growbx/growbx-KiCAD-Lib/README.md

# growbx-KiCAD-Lib
Internal KiCAD component library for all growbox electrical systems.

Format and organiztion of this library follows AVR-Method found here:
https://github.com/adamjvr/AVR-method
