growbx/growbx-KiCAD-Lib/(commit log)

2020-02-26 MGM210P Module
    Footprint and schematic symbol created for MGM210P module. Capacitor and Resitor footprints added.
2020-02-26 MCP23017
    MCP23017 symbol and footprint added to library
2020-02-28 Ti 3D
    3D File added to Ti ADC and scaled accordingly
2020-02-28 Caps and Res
    Capacitors and Resistor footprints modified with 3D models. 4K7 and 10K resistores added to library.
2020-02-28 Resistors, Capacitor, and Switch
    Standard selection of resistors for digital systems added to library. Basic bypass capacitors, analog, and digital filtering caps added as well. Development reset switch also added.
2020-02-29 SHT35
    SHT35 sensor added to library with 3D model
2020-02-29 Link
    Symbol and footprint linked for SHT35,
2020-03-01 Molex USB
    USB micro B connector from Molex added, 1050170001
    USB - micro B USB 2.0 Receptacle Connector 5 Position Surface Mount, Right Angle; Through Hole
2020-03-01 Battery Holder
    Battery Holder BK-912 for 2032 coin cell batterys added
2020-03-01 LDO 3.3V regulator
    LDO regulator for 3.3V rail when USB powered. AP7361C-33FGE-7
    Linear Voltage Regulator IC 1 Output 1A U-DFN3030-8 (Type E)
2020-03-01 Ceramic Cap
    Ceramic cap added for voltage regulator GRM155R61A475MEAAD.
    4.7µF ±20% 10V Ceramic Capacitor X5R 0402 (1005 Metric)
2020-03-02 Adjustments and Inductor
    Power inductor and components adjusted for readability
2020-03-02 Diode and Transistor
    Added a diode and transistor for USB power switching circuit. BAT20JFILM and DMP3125L-7
2020-03-02 Components Added
    Pin header connectgors, LEDs, and adjustments to IC shapes
2020-03-02 JTAG Connector
    ARM Cortex M JTAG connector added to library
2020-03-07 Connectors
    UFL connector added and Battery holder for thicker coin cell added.
2020-03-10 Connectors and Eval Board
    STM32 Eval kit added as component, this took a lot of time and may have some errors we should test it before ordering boards. Added Peonix contact screw terminal connectors , same as stepper drivers.
2020-03-10 Power Capacitors
    added power capacitors from Nichion
2020-03-11 Reed Switch and Tag Connect
    Added symbol and footprint for both the CT10-1530-G1 magnetic reed switch and the tag connect programming interface.
2020-03-12 Connectors and Regulators
    Pololu dcdc module footprint and symbol fixed. Two pole Phoenix contact connector added.
2020-03-16 Parts Added
    LED driver from Ti
    Diodes Inc TVS diode
    Pulse RJ45 jack
2020-03-17 40 Pin
    RPi 40 pin header added
2020-03-20 D36V50Fx Pololu
    D36V50Fx Pololu regulators added to library, 3.3v, 5v, and 12v versions.
2020-03-26 Components Added
    Added bicolor LED, added I2C mux, added power modules.
2020-03-26 Connectors and resistors
    PoE header added and current set resistor for LED drivers added
2020-03-27 Footprints Added
    Added footprint for RPi header, footprint link issues resolved for other parts.
2020-04-03 5 Position Phoenix COntact
    added 5 position phoenix connector
2020-04-07 rpI4
    Added mounting holes for RPi4, 25mm fan component, and created a RPi4 shape as a footprint.
2020-04-08 Regulator Parts
    COmponents for DCDC regulator on occupancy sensor created and added.
2020-04-13 Bridge Rectifier Diode Added
    Added part for Bridge Rectifier diode as a single component.
2020-04-16 Fan 3D and Lightpipe
    Added 3D model for 25mm fan and lightpipe part
2020-04-21 Components added
    PIR sensor and crystals added
2020-04-29 Diodes
    TVS diodes of various types added.
2020-04-30 Fixed Diode
    Fixed diode so silkscreen dot indicates direction
2020-05-18 Headers and Switches
    Femal headers for arduino compatible products and DIP switches
2020-05-21 Footprint tweaks
    Removed via in pad
2020-06-01 ARduino DUE footprint
    added Arduino DUE shield template footprint
2020-06-05 Charge Control and Monitoring
    Battery charge controller and monitoring ICs added.
2020-06-08 adjusted IC
    added GND pin for pad on coulomb counter IC
2020-06-09 Rectifier diode
    Rectifier diode footprint reworked, original was completely wrong
2020-08-18 Connectors and Regulators
    COnnectors and DCDC converter
2021-05-24 Create RAK3172(H).kicad_mod
    Add RAK3172 to Lib
2021-06-03 Add orange and red LEDs
    Added LTST-C194 type LEDs in new colors
2021-06-08 Added RF conn, I2C conn, and changed naming of board layout
2021-06-15 Update RAK3172(H).kicad_mod
    Moved pins to correct placement according to the RAK documentation
2021-06-17 Add JST PH for I2C, remove SMA, Add labels
